middle-river/color_epd_photo3/README.txt

http://middleriver.chagasi.com/electronics/color_epd_photo3/
