middle-river/color_epd_photo3/docs/README.md

<!DOCTYPE html>
<html>
<body style="background-color: #ccccff;">
<!-- var -->
<p>[English] <a href="#lang_ja">[日本語]</a></p>
<h1 align="center">Large Photo Frame with 13.3 inch 6 Color E-Paper</h1>
<h2>Introduction</h2>
<p>After making a <a href="https&#58;//github.com/middle-river/color_epd_photo2">photo frame using a 7.3 inch 7 color e-paper display</a>, I newly got a new 13.3 inch 6 color e-paper, so I compared the image quality with the previous e-paper and created another photo frame.</p>
<h2>Comparison of Color E-Papers (ACeP vs. Spectra 6)</h2>
<p>This new e-paper uses a new technology called Spectra 6 (E6). Compared to the previous ACeP technology, Spectra 6 has only six colors compared with seven colors of ACeP, but is said to be able to display more saturated colors. I couldn't find much evaluation results about the image quality of this e-paper, therefore compared the image quality with that of the previous color e-paper.</p>
<h3>Measuring Colors Precisely</h3>
<p>Pictures taken with digital cameras are affected by various factors like lighting and and image processing in the cameras. Therefore, I will apply color correction using a color chart (color checker). There are commercial software programs for color correction but I used here the ColorCorrectionModel library in OpenCV. Color correction is performed by affine transforming the RGB color channels. It can also automatically detect a color chart in an image. This OpenCV library is highly customizable, so any color chart can be used as long as the exact colors are known (in the Lab color space). Here, I used a 24-color chart from Charttu. There seem to be several other color charts, in addition to major color checkers from X-Rite and Datacolor, such as the Pantone Color Matching Card and DGK Color Calibration Chart.</p>
<p>For color correction, it is best to use images obtained from image sensors of digital cameras directly. Color correction may not be accurate for images which undergone nonlinear processing such as white balance adjustment and noise reduction. In this evaluation, I used RAW images taken with a mirrorless camera, and converted them as Linear 16 bit images using the dcraw program. The code used for color correction can be found <a href="https&#58;//github.com/middle-river/color_epd_photo3/tree/main/color_correction">here</a>. All of the photos on this page that show a color chart were taken under natural light and color-corrected.</p>
<h3>Comparison with Color Patterns</h3>
<p>First, I created simple color pattern images with 7 or 6 colors for comparison. Below are the color patterns and the commands I used to generate the images.</p>
<div align="center">
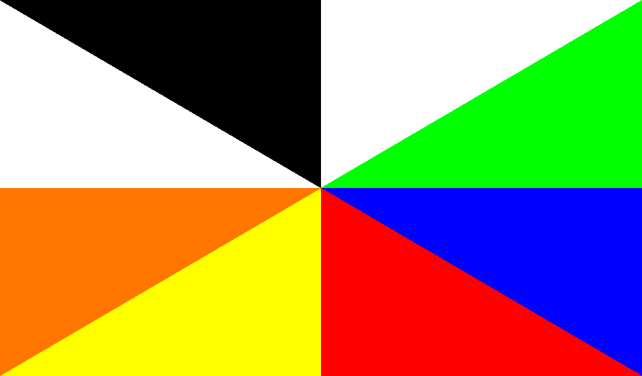
[picture p1: docs/pattern_lcd_1024x600.png]
<figure style="display: inline-table;"><a href="pattern_lcd_1024x600.png"><figcaption>Color pattern for 7&quot; tablet</figcaption></a></figure>
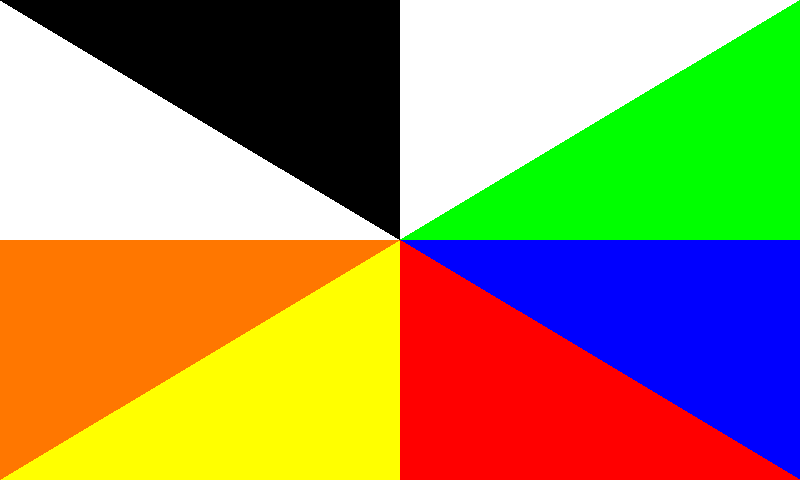
[picture p2: docs/pattern_acep_800x480.png]
<figure style="display: inline-table;"><a href="pattern_acep_800x480.png"><figcaption>Color pattern for 7.3&quot; ACeP</figcaption></a></figure>
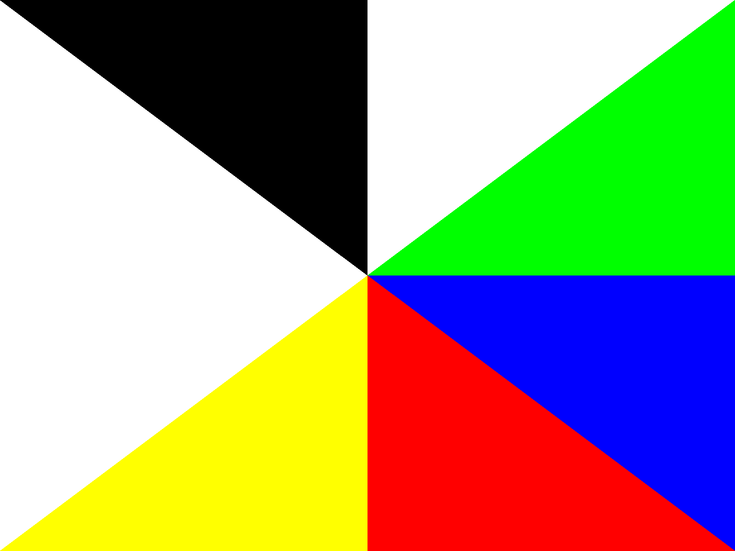
[picture p3: docs/pattern_spectra6_1600x1200.png]
<figure style="display: inline-table;"><a href="pattern_spectra6_1600x1200.png"><figcaption>Color pattern for 13.3&quot; Spectra 6</figcaption></a></figure>
</div>

<pre style="background-color: #ccffcc">
convert -size 1024x600 "xc:white" +antialias \
  -draw "fill #000000 polygon 0,0, 511.5,299.5 511.5,0" \
  -draw "fill #ffffff polygon 511.5,0, 511.5,299.5 1023,0" \
  -draw "fill #00ff00 polygon 1023,0, 511.5,299.5 1023,299.5" \
  -draw "fill #0000ff polygon 1023,299.5, 511.5,299.5 1023,599" \
  -draw "fill #ff0000 polygon 1023,599, 511.5,299.5 511.5,599" \
  -draw "fill #ffff00 polygon 511.5,599, 511.5,299.5 0,599" \
  -draw "fill #ff7700 polygon 0,599, 511.5,299.5 0,299.5" \
  pattern_lcd_1024x600.png

convert -size 800x480 "xc:white" +antialias \
  -draw "fill #000000 polygon 0,0, 399.5,239.5 399.5,0" \
  -draw "fill #ffffff polygon 399.5,0, 399.5,239.5 799,0" \
  -draw "fill #00ff00 polygon 799,0, 399.5,239.5 799,239.5" \
  -draw "fill #0000ff polygon 799,239.5, 399.5,239.5 799,479" \
  -draw "fill #ff0000 polygon 799,479, 399.5,239.5 399.5,479" \
  -draw "fill #ffff00 polygon 399.5,479, 399.5,239.5 0,479" \
  -draw "fill #ff7700 polygon 0,479, 399.5,239.5 0,239.5" \
  pattern_acep_800x480.png

convert -size 1600x1200 "xc:white" +antialias \
  -draw "fill #000000 polygon 0,0, 799.5,599.5 799.5,0" \
  -draw "fill #ffffff polygon 799.5,0, 799.5,599.5 1599,0" \
  -draw "fill #00ff00 polygon 1599,0, 799.5,599.5 1599,599.5" \
  -draw "fill #0000ff polygon 1599,599.5, 799.5,599.5 1599,1199" \
  -draw "fill #ff0000 polygon 1599,1199, 799.5,599.5 799.5,1199" \
  -draw "fill #ffff00 polygon 799.5,1199, 799.5,599.5 0,1199" \
  pattern_spectra6_1600x1200.png
</pre>
<p>The photo below compares these color patterns that are actually displayed.</p>
<div align="center">
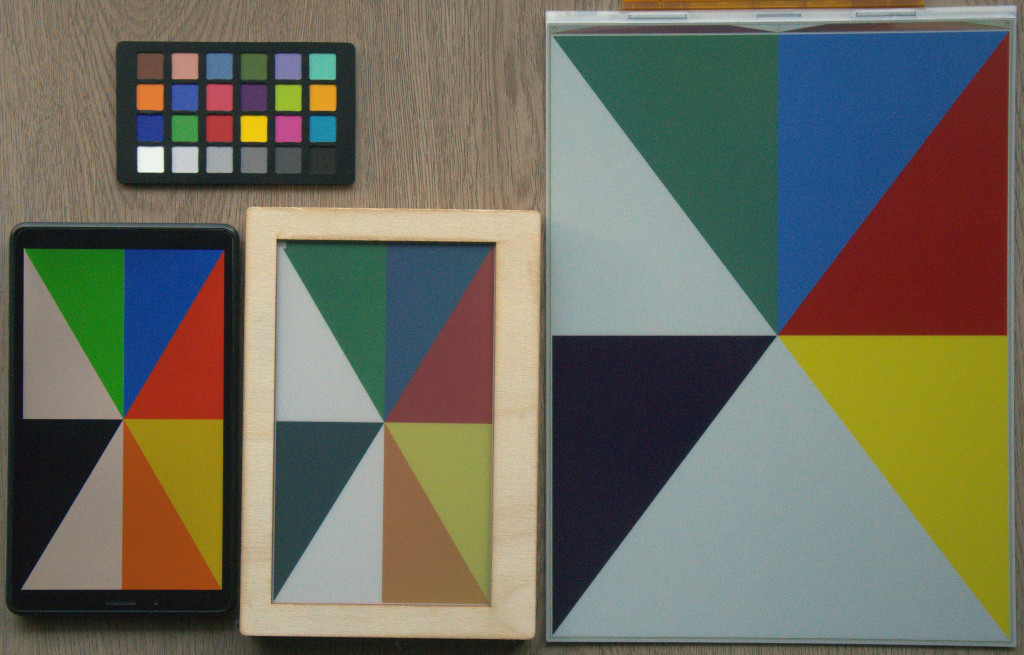
[picture p4: docs/pattern_comparison.jpg]
<figure style="display: inline-table;"><a href="pattern_comparison.jpg"><figcaption>Comparison of color patterns (from left&#58; tablet, ACeP, Spectra 6)</figcaption></a></figure>
</div>
<p>From the left, there are an LCD display (7&quot; tablet Lenovo Tab M7 3rd Gen, screen brightness of 50%), a 7.3&quot; ACeP color e-paper, and a 13.3&quot; Spectra 6 color e-paper. Naturally, the e-papers have inferior color saturation compared to the LCD.</p>
<p>The RGB and HSV values for each color on the e-papers were as follows&#58;</p>
<table align="center" border="1">
<tr>
<td align="center"><strong>Color</strong></td>
<td align="center"><strong>Pure Color (RGB)</strong></td>
<td align="center"><strong>ACeP (RGB)</strong></td>
<td align="center"><strong>Spectra 6 (RGB)</strong></td>
<td align="center"><strong>Pure Color (HSV)</strong></td>
<td align="center"><strong>ACeP (HSV)</strong></td>
<td align="center"><strong>Spectra 6 (HSV)</strong></td>
</tr>
<tr>
<td align="center">Black</td>
<td align="center">(  0,   0,   0)</td>
<td align="center">( 46,  67,  71)</td>
<td align="center">( 30,  27,  43) </td>
<td align="center">(0  ,   0,   0)</td>
<td align="center">(189,  35,  27)</td>
<td align="center">(251,  37,  16)</td>
</tr>
<tr>
<td align="center">White</td>
<td align="center">(255, 255, 255)</td>
<td align="center">(176, 182, 178)</td>
<td align="center">(156, 171, 169) </td>
<td align="center">(0  ,   0, 100)</td>
<td align="center">(140,   3,  71)</td>
<td align="center">(172,   8,  67)</td>
</tr>
<tr>
<td align="center">Green</td>
<td align="center">(  0, 255,   0)</td>
<td align="center">( 49,  99,  75)</td>
<td align="center">( 49,  92,  77) </td>
<td align="center">(120, 100, 100)</td>
<td align="center">(151,  50,  38)</td>
<td align="center">(159,  46,  36)</td>
</tr>
<tr>
<td align="center">Blue</td>
<td align="center">(  0,   0, 255)</td>
<td align="center">( 54,  82, 105)</td>
<td align="center">( 35,  81, 136) </td>
<td align="center">(240, 100, 100)</td>
<td align="center">(207,  48,  41)</td>
<td align="center">(212,  74,  53)</td>
</tr>
<tr>
<td align="center">Red</td>
<td align="center">(255,   0,   0)</td>
<td align="center">(121,  64,  65)</td>
<td align="center">(109,  26,  23) </td>
<td align="center">(  0, 100, 100)</td>
<td align="center">(358,  47,  47)</td>
<td align="center">(  2,  78,  42)</td>
</tr>
<tr>
<td align="center">Yellow</td>
<td align="center">(255, 255,   0)</td>
<td align="center">(151, 154,  77)</td>
<td align="center">(153, 149,  23) </td>
<td align="center">( 60, 100, 100)</td>
<td align="center">( 62,  50,  60)</td>
<td align="center">( 58,  84,  60)</td>
</tr>
<tr>
<td align="center">Orange</td>
<td align="center">(255, 127,   0)</td>
<td align="center">(138, 102,  68)</td>
<td align="center">N/A             </td>
<td align="center">( 29, 100, 100)</td>
<td align="center">( 29,  50,  54)</td>
<td align="center">N/A</td>
</tr>
</table>
<p>Comparing saturation in the photo and RGB values, Spectra 6 is better than ACeP in blue, red, and yellow, but green is slightly worse.</p>
<h3>Comparison with Test Images</h3>
<p>The e-papers were compared using test images. Since color e-papers can display only 7 or 6 colors, we need to reduce the number of colors in images using color palettes and dithering. Here, the following four color palettes were used.</p>
<dl>
<dt><strong>Palette A</strong></dt>
<dd>Pure color palette (&quot;Pure Colors (RGB)&quot; in the table above)</dd>
<dt><strong>Palette B</strong></dt>
<dd>Actual display color palette (&quot;Spectra 6 (RGB)&quot; in the table above)</dd>
<dt><strong>Palette C</strong></dt>
<dd>Color palette derived from a sample image of ACeP e-paper (See &quot;sample image palette&quot; in the <a href="https&#58;//github.com/middle-river/color_epd_photo2">previous project</a>)</dd>
<dt><strong>Palette D</strong></dt>
<dd>Color palette adaptively determined for images (See &quot;Experiment of Optimizing Palettes&quot; in the <a href="https&#58;//github.com/middle-river/color_epd_photo2">previous project</a>)</dd>
</dl>
<p><a href="https&#58;//github.com/middle-river/color_epd_photo3/tree/main/tool/reduce_colors.py">This</a> (Palette A-C) and <a href="https&#58;//github.com/middle-river/color_epd_photo2/tree/main/palette_optimizer/convert_colors.py">this</a> (Palette D) scripts were used for color reduction. The images used for the test were available in <a href="https&#58;//www.northlight-images.co.uk/printer-test-images/">this page</a>.</p>
<div align="center">
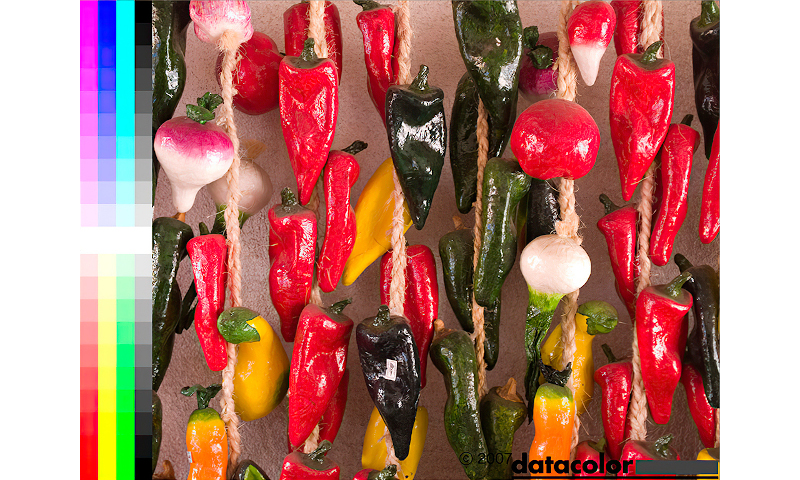
[picture p5: docs/datacolor0.jpg]
<figure style="display: inline-table;"><a href="datacolor0.jpg"><figcaption>Image A</figcaption></a></figure>
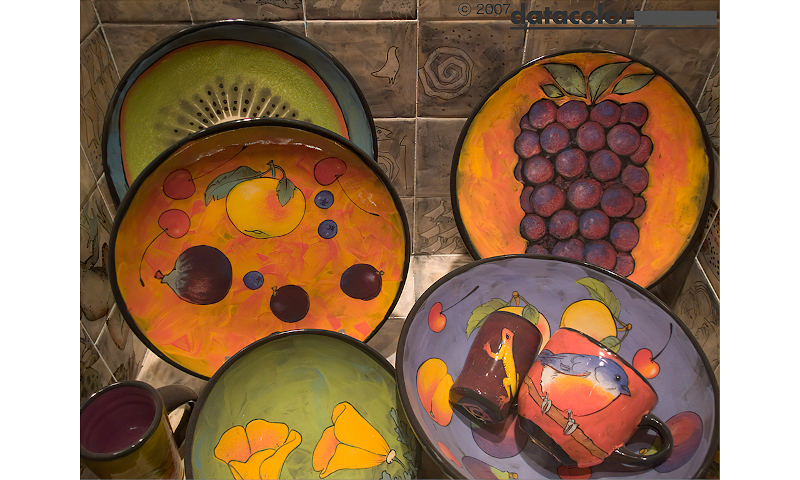
[picture p6: docs/datacolor1.jpg]
<figure style="display: inline-table;"><a href="datacolor1.jpg"><figcaption>Image B</figcaption></a></figure>
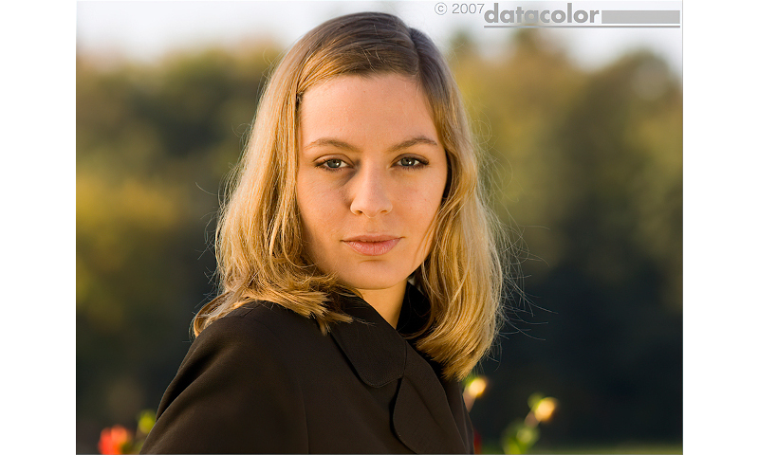
[picture p7: docs/datacolor2.jpg]
<figure style="display: inline-table;"><a href="datacolor2.jpg"><figcaption>Image C</figcaption></a></figure>
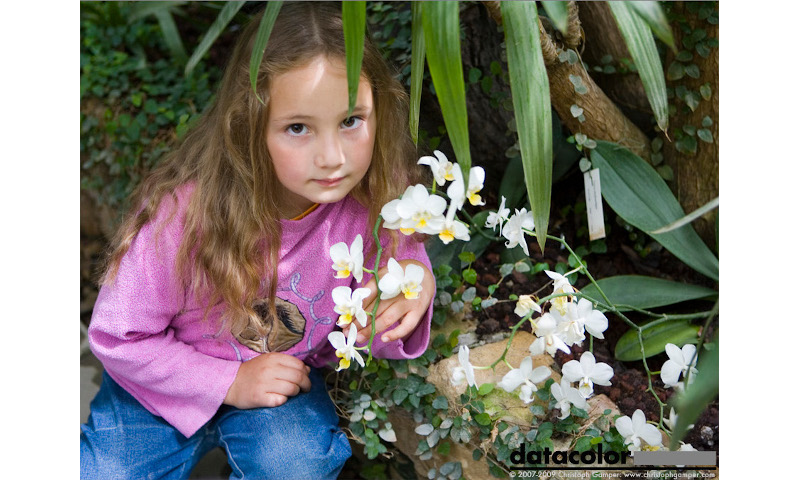
[picture p8: docs/datacolor3.jpg]
<figure style="display: inline-table;"><a href="datacolor3.jpg"><figcaption>Image D</figcaption></a></figure>
</div>
<p>The results are shown below.</p>
<div align="center">
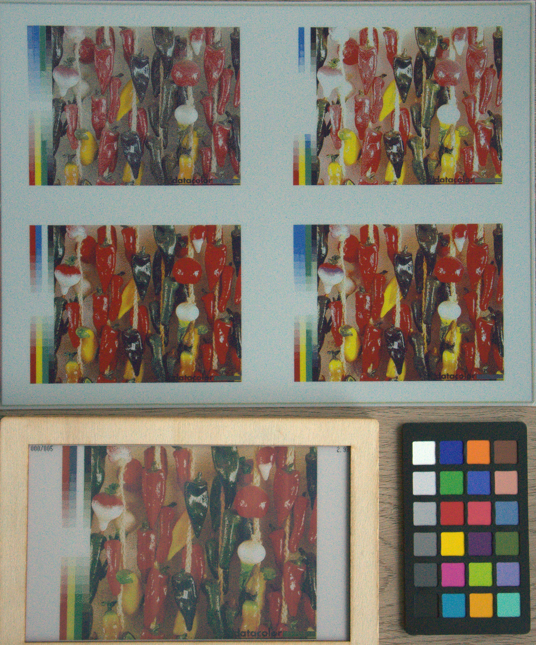
[picture p9: docs/result0.jpg]
<figure style="display: inline-table;"><a href="result0.jpg"><figcaption>Result of Image A</figcaption></a></figure>
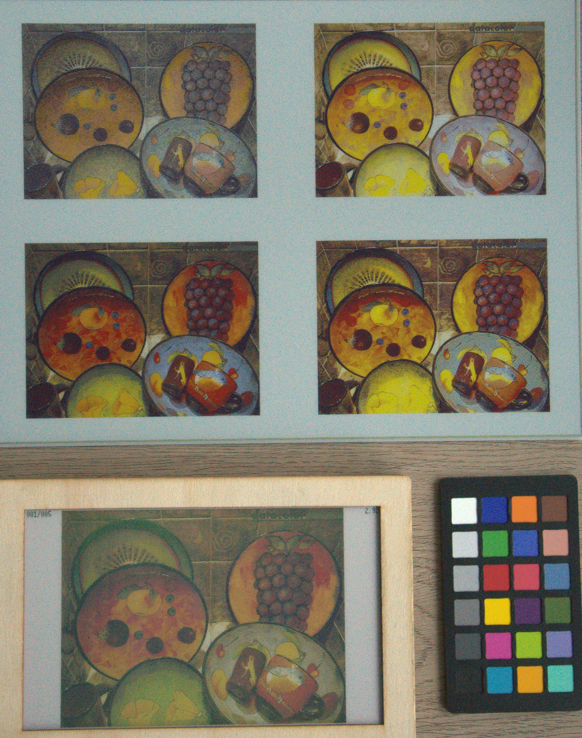
[picture p10: docs/result1.jpg]
<figure style="display: inline-table;"><a href="result1.jpg"><figcaption>Result of Image B</figcaption></a></figure>
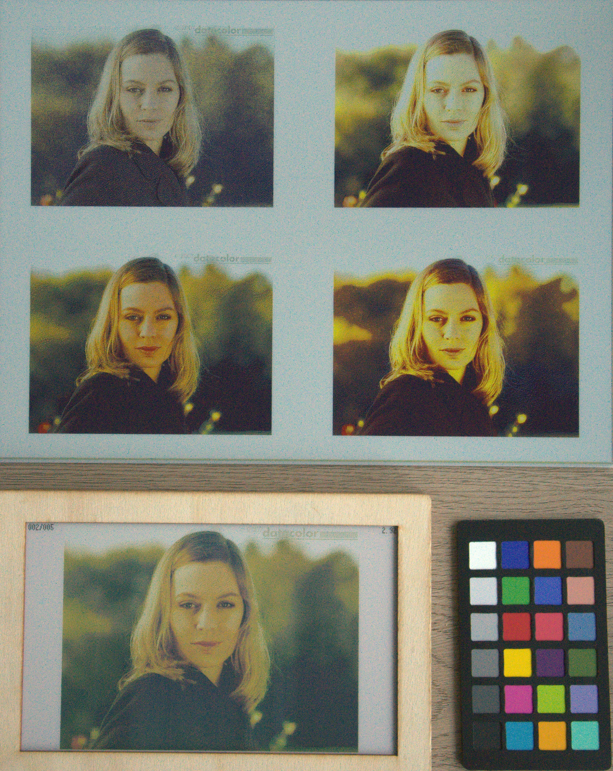
[picture p11: docs/result2.jpg]
<figure style="display: inline-table;"><a href="result2.jpg"><figcaption>Result of Image C</figcaption></a></figure>
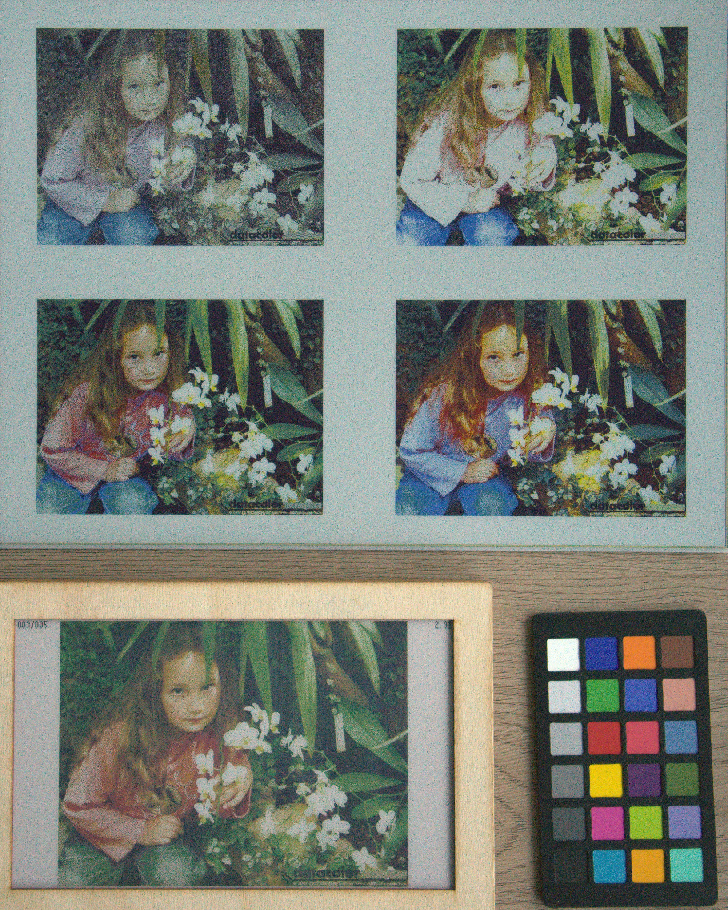
[picture p12: docs/result3.jpg]
<figure style="display: inline-table;"><a href="result3.jpg"><figcaption>Result of Image D</figcaption></a></figure>
</div>
<p>In these pictures, the top is the 13.3&quot; Spectra 6, and the bottom left is the 7.3&quot; ACeP. There are four images in the 13.3&quot; model&#58; the top left uses Palette A, the top right uses Palette B, the bottom left uses Palette C, and the bottom right uses Palette D. The 7.3&quot; model always uses Palette C. All images are the same size, 800x480.</p>
<p>The differences between the palettes can be seen with the 13.3&quot; display. Palette A (pure color palette) is always low in saturation and noisy. Palette B (actual palette) has blown out highlights. Palette C (palette from a sample image) has relatively stable image quality for all images. Palette D (adaptive palette) has slightly higher contrast than Palette C but colors may shift. When comparing the 13.3&quot; Spectra 6 (Palette C) to the 7.3&quot; ACeP (Palette C), the Spectra 6 often produces slightly more vibrant results. As described in the <a href="https&#58;//github.com/middle-river/color_epd_photo2">previous page</a> , color palettes used for color reduction largely impact on image quality. Palette C was originally obtained from a sample image of ACeP e-paper, but it also gave good results on Spectra 6.</p>
<p>7.3 inch ACeP took 32 seconds and 13.3 inch Spectra 6 took 22 seconds for refreshing the screen.</p>
<h2>Hardware</h2>
<p>The 6 color e-paper used here is <a href="https&#58;//www.waveshare.com/13.3inch-e-paper-hat-plus-e.htm?sku=29355">Waveshare 13.3inch e-Paper HAT+ (E)</a>, with the resolution of 1200x1600. The control of this e-paper is a bit tricky compared to previous ones. It has two controllers, and there are two chip select (CS) signals. The PWR signal was added to completely cut off the power supply with MOS-FET, so power consumption can be reduced to zero when not in use (not applicable to Raspberry Pi GPIO pins). There is a D/C signal to distinguish between commands and data, but it is not actually used. Data are sent immediately after each command, and CS must be kept low during the whole cycle. This is a large e-paper, and the current consumption is large (1.4 A at maximum according to the specification). It did not work with two AA batteries due to voltage drop.</p>
<p>ESP32 with 16 MB flash memory was used for controlling the e-paper. 1,280 KB was assigned to the program area, and the rest to LittleFS storage area.</p>
<p>The circuit is similar to the previous one, and the wiring is as follows.</p>
<table align="center" border="1">
<tr>
<td align="left">BAT&#58;4.5V</td>
<td align="left">EPD&#58;VCC</td>
</tr>
<tr>
<td align="left">BAT&#58;GND</td>
<td align="left">EPD&#58;GND</td>
</tr>
<tr>
<td align="left">ESP&#58;3V3</td>
<td align="left">BAT&#58;3.3V</td>
</tr>
<tr>
<td align="left">ESP&#58;GND</td>
<td align="left">BAT&#58;GND</td>
</tr>
<tr>
<td align="left">ESP&#58;IO23(MOSI)</td>
<td align="left">EPD&#58;DIN</td>
</tr>
<tr>
<td align="left">ESP&#58;IO18(CLK)</td>
<td align="left">EPD&#58;SCK</td>
</tr>
<tr>
<td align="left">ESP&#58;IO19</td>
<td align="left">EPD&#58;CS_M</td>
</tr>
<tr>
<td align="left">ESP&#58;IO22</td>
<td align="left">EPD&#58;CS_S</td>
</tr>
<tr>
<td align="left">ESP&#58;IO21</td>
<td align="left">EPD&#58;DC</td>
</tr>
<tr>
<td align="left">ESP&#58;IO17</td>
<td align="left">EPD&#58;RST</td>
</tr>
<tr>
<td align="left">ESP&#58;IO16</td>
<td align="left">EPD&#58;BUSY</td>
</tr>
<tr>
<td align="left">ESP&#58;IO4</td>
<td align="left">EPD&#58;PWR</td>
</tr>
<tr>
<td align="left">ESP&#58;IO3(RXD)</td>
<td align="left">CON&#58;RXD</td>
</tr>
<tr>
<td align="left">ESP&#58;IO1(TXD)</td>
<td align="left">CON&#58;TXD</td>
</tr>
</table>
<p>ESP, EPD, BAT, and CON respectively represent ESP32, e-paper, battery, and the connector for programming the flash. Three AA batteries are used for power suply&#58; 4.5 V is input to the e-paper, and 3.3 V is input to ESP32 which is obtained with MCP1700T-3302E. A battery holder with a small contact resistance is used since a large current is drained. A 11x14 inch photo frame is used for enclosing the e-paper.</p>
<div align="center">
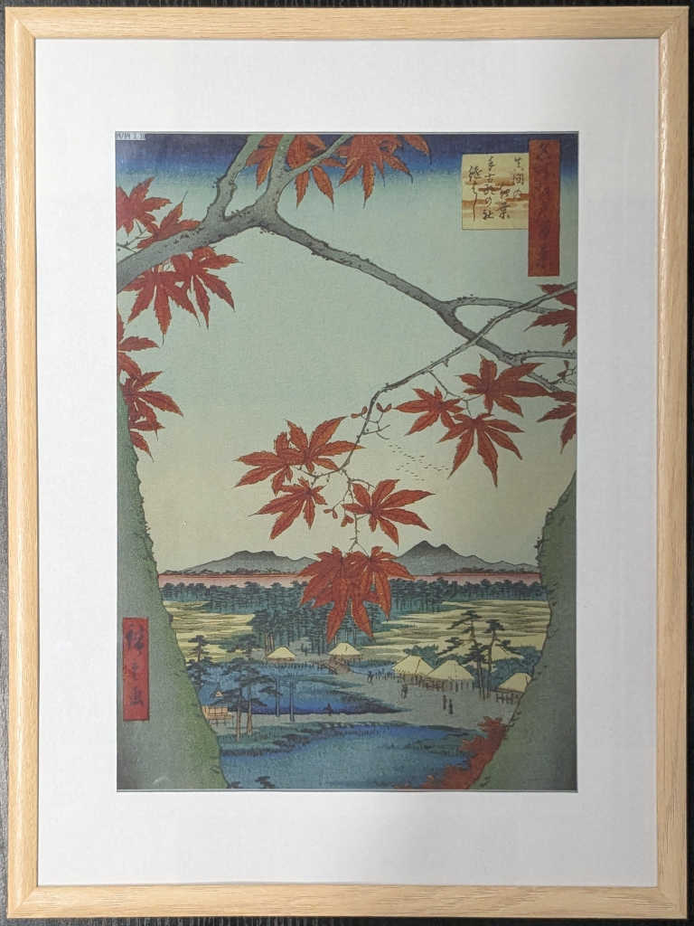
[picture p13: docs/front.jpg]
<figure style="display: inline-table;"><a href="front.jpg"><figcaption>Cased device (front)</figcaption></a></figure>
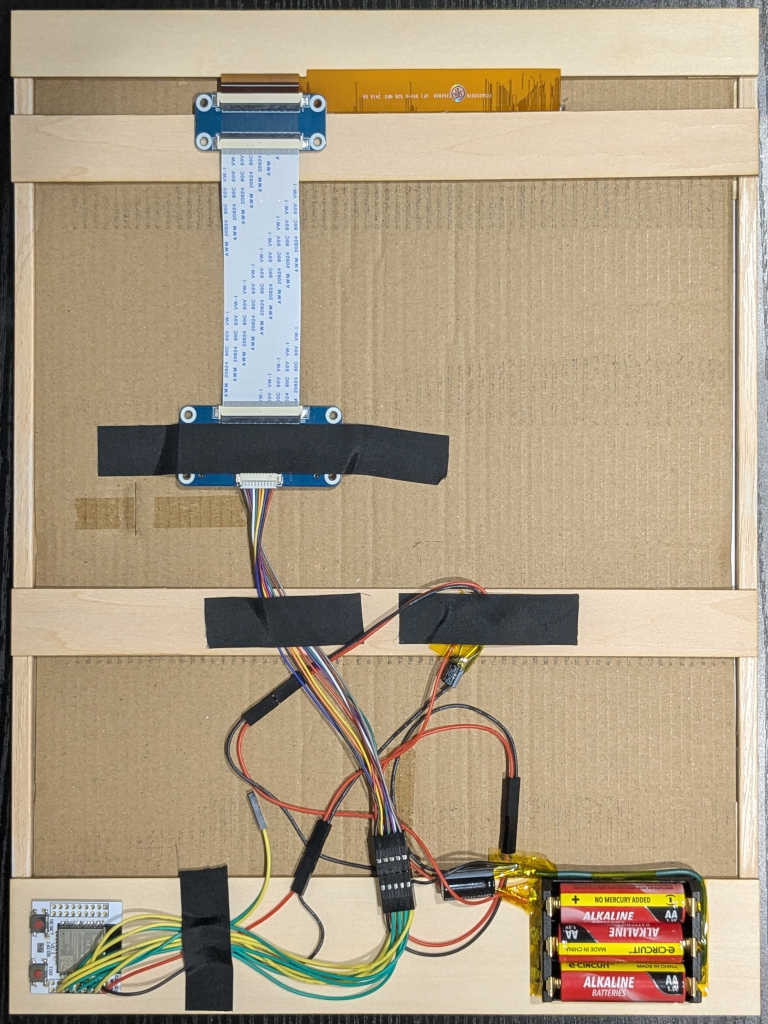
[picture p14: docs/back.jpg]
<figure style="display: inline-table;"><a href="back.jpg"><figcaption>Cased device (back)</figcaption></a></figure>
</div>
<h2>Software</h2>
<p>A <a href="https&#58;//github.com/middle-river/color_epd_photo3/tree/main/firmware">firmware</a> for the Arduino ESP32 was written in order to use this 13.3&quot; e-paper as a photo frame.</p>
<h3>Usage</h3>
<p>This photo frame is normally in the deep sleep state, but it wakes up and rewrite images when the specified sleep time has elapsed or the tactile switch (connected to GPIO0) is pressed. This photo frame is controlled using only the single switch. By pressing the switch when powering on or resetting, several settings can be configured and image data can be transferred. There exist the following operating modes.</p>
<ul>
<li><strong>Configuration mode</strong><br>This mode is activated when the switch is pressed for 2 seconds or more within 3 seconds after power-on. The device will sleep by sending an empty string as the key.</li>
<li><strong>Sync mode</strong><br>This mode is activated when the switch is pressed less than 2 seconds within 3 seconds after power-on. The device will sleep after syncing the data.</li>
<li><strong>Transfer mode</strong><br>This mode is activated when the switch is pressed two times within 3 seconds after power-on. The device will sleep when the switch is pressed once again.</li>
<li><strong>Displaying the next image</strong><br>This mode is activated when the switch is pressed less than 2 seconds in the sleep state, or the sleep time elapsed. The device will sleep after displaying the next image.</li>
<li><strong>Displaying the previous image</strong><br>This mode is activated when the switch is pressed 2 seconds or more in the sleep state. The device will sleep after displaying the previous image.</li>
<li><strong>Displaying the 5th next image</strong><br>This mode is activated when the switch is pressed two times in the sleep state. The device will sleep after displaying the 5th next image.</li>
<li><strong>Displaying the 5th previous image</strong><br>This mode is activated when the switch is pressed three times in the sleep state. The device will sleep after displaying the 5th previous image.</li>
</ul>
<p>In the configuration mode, an HTTP server runs in the Access Point mode. The device can be configured by connecting to the server (SSID is &quot;ESP32&quot;, password is &quot;12345678&quot;, and URL is &quot;http&#58;//192.168.0.1/&quot;) with a smartphone or tablet. Any key-value pair can be registered in this mode. The SSID/password for the transfer/sync mode, the URL for the sync mode, and the sleep time (in seconds) are set using the keys &quot;SSID&quot;, &quot;PASS&quot;, &quot;URL&quot;, and &quot;SLEEP&quot; respectively. These values are saved on the flash memory.</p>
<p>In the sync mode, image files in a specified web server directory are automatically transferred to the ESP32. The server directory needs to be set for the key &quot;URL&quot; in the configuration mode. The URL needs to end with a slash. HTTP Basic Authentication can be used with a URL like &quot;http&#58;//user&#58;password@example.com/dir/subdir/&quot;. Note that file sizes are used for checking file identity, so files will not be updated when the files in the server are replaced with new files with the same sizes. It is also possible to update key-value configurations by putting a file named config.txt in the directory, which has a tab-separated key-value pair in each line. In the web server directory for storing images, the following files .htaccess and index.cgi also need to be placed in order to obtain the list of files.</p>

<pre style="background-color: #ccffcc">
[.htaccess]
Options +ExecCGI
AddHandler cgi-script .cgi

[index.cgi]
#!/bin/sh
echo "Content-Type: text/plain"
echo ""
find . -maxdepth 1 -name "*.gif" -printf '%s %f\n'
</pre>
<p>In the transfer mode, the device connects to an access point in the Station mode and runs an FTP server. We can connect with FTP client software and upload or delete image files. In Windows, File Explorer can be used as an FTP client. All image files need to be placed in the root directory of ESP32. I used the Arduino library SimpleFTPServer (in order to use LittleFS instead of SPIFFS, DEFAULT_STORAGE_TYPE_ESP32 in FtpServerKey.h needs to be changed from STORAGE_SPIFFS to STORAGE_LITTLEFS).</p>
<h3>Image Data</h3>
<p>Image data are stored in the GIF format as in the previous photo frame. Since this e-paper has two controllers assigned to the left and right sides of the display area and needs to transfer data separately, 1200x1600 images are divided into left and right halves and converted into 600x3200 images by vertically merging in advance. File sizes depend on the images, but they were usually around 250 to 450KB. About 60 images can be stored when 15 MB is assigned to LittleFS and the size of each image is 250 KB.</p>
<p>The power voltage of ESP32 and the index number of the currently displaying image are shown  in the upper left corner of the screen.</p>
<h2>Final Thoughts</h2>
<p>Compared to the ACeP e-paper, the image quality of the Spectra 6 e-paper was not different as I expected. The difference is recognizable when compared side by side, but the image resolution is similary limited due to dithering since each pixel can only display six colors. The faster refresh time is one advantage of the new e-paper.</p>
<hr>
<!-- var -->
<p><a href="#lang_en">[English]</a> [日本語]</p>
<h1 align="center">13.3インチ6色カラー電子ペーパーを使った大型フォトフレーム</h1>
<h2>はじめに</h2>
<p>最近<a href="https&#58;//github.com/middle-river/color_epd_photo2">7.3インチの7色カラー電子ペーパーを使用してフォトフレームを作成</a>しましたが、新型の13.3インチ6色カラー電子ペーパーを新たに入手したので、以前の電子ペーパーと画質を比較して、フォトフレームを作りました。</p>
<h2>カラー電子ペーパーの比較(ACePとSpectra 6)</h2>
<p>今回使用した電子ペーパーは13.3インチと大型であることの他に、Spectra 6 (E6)という新しい技術が使われているという特徴があります。Spectra 6は以前のカラー電子ペーパーで使われていたACePという技術と比較して、表示可能な色数は7色から6色に減りますがより高彩度の表示ができると言われています。しかしながらWeb上ではこの電子ペーパーの画質に関する客観的な情報があまり見つからなかったので、以前のカラー電子ペーパーと画質を比べてみました。</p>
<h3>正確な色の測定</h3>
<p>デジカメで電子ペーパーの表示結果を撮影した場合、その画像は照明やカメラの画像処理エンジンなど様々な要素の影響を受けます。そこで今回はカラーチャート(カラーチェッカー)を使って撮影した写真の色を補正することにしました。色補正をするソフトは市販のものもありますが、OpenCVにColorCorrectionModelというライブラリがあるのでそれを使いました。基本的にRGBのカラーチャンネルをアフィン変換することで色補正を行います。また画像の中からカラーチャートを自動検出することもできます。このOpenCVのライブラリはカスタマイズ性が高いので、正確な色(Lab色空間での値)が分かっていればどのようなカラーチャートでも利用できます。今回は、Charttu社の24色のカラーチャートを使用しました。X-Rite社やDatacolor社のメジャーなカラーチェッカーの他に、Pantone Color Matching CardやDGK Color Calibration Chartなどいくつかの色補正用カラーチャートが存在するようです。</p>
<p>色補正の対象となる画像はイメージセンサーから出力された値を直接使うのが望ましく、ホワイトバランス調整やノイズ除去などの非線形な処理を行った画像に対しては色補正の精度が悪くなります。そこで今回は、デジタル一眼カメラで撮影したRAWデータをdcrawというソフトでLinear 16 bitで現像した画像を使いました。色補正に使用したコードは<a href="https&#58;//github.com/middle-river/color_epd_photo3/tree/main/color_correction">ここ</a>にあります。このページに載せた写真でカラーチャートが写っているものは、全て自然光の下で撮影して色補正を行った後の写真です(ただし縮小してJPEG圧縮してあります)。</p>
<h3>カラーパターンの比較</h3>
<p>まず最初に、7色または6色からなる単純なカラーパターンを作成して比較しました。以下にそのカラーパターンと、画像生成に使用したコマンドを示します。</p>
<div align="center">
<figure style="display: inline-table;"><a href="pattern_lcd_1024x600.png"><figcaption>7インチタブレット用パターン</figcaption></a></figure>
<figure style="display: inline-table;"><a href="pattern_acep_800x480.png"><figcaption>7.3インチACeP用パターン</figcaption></a></figure>
<figure style="display: inline-table;"><a href="pattern_spectra6_1600x1200.png"><figcaption>13.3インチSpectra 6用パターン</figcaption></a></figure>
</div>

<pre style="background-color: #ccffcc">
convert -size 1024x600 "xc:white" +antialias \
  -draw "fill #000000 polygon 0,0, 511.5,299.5 511.5,0" \
  -draw "fill #ffffff polygon 511.5,0, 511.5,299.5 1023,0" \
  -draw "fill #00ff00 polygon 1023,0, 511.5,299.5 1023,299.5" \
  -draw "fill #0000ff polygon 1023,299.5, 511.5,299.5 1023,599" \
  -draw "fill #ff0000 polygon 1023,599, 511.5,299.5 511.5,599" \
  -draw "fill #ffff00 polygon 511.5,599, 511.5,299.5 0,599" \
  -draw "fill #ff7700 polygon 0,599, 511.5,299.5 0,299.5" \
  pattern_lcd_1024x600.png

convert -size 800x480 "xc:white" +antialias \
  -draw "fill #000000 polygon 0,0, 399.5,239.5 399.5,0" \
  -draw "fill #ffffff polygon 399.5,0, 399.5,239.5 799,0" \
  -draw "fill #00ff00 polygon 799,0, 399.5,239.5 799,239.5" \
  -draw "fill #0000ff polygon 799,239.5, 399.5,239.5 799,479" \
  -draw "fill #ff0000 polygon 799,479, 399.5,239.5 399.5,479" \
  -draw "fill #ffff00 polygon 399.5,479, 399.5,239.5 0,479" \
  -draw "fill #ff7700 polygon 0,479, 399.5,239.5 0,239.5" \
  pattern_acep_800x480.png

convert -size 1600x1200 "xc:white" +antialias \
  -draw "fill #000000 polygon 0,0, 799.5,599.5 799.5,0" \
  -draw "fill #ffffff polygon 799.5,0, 799.5,599.5 1599,0" \
  -draw "fill #00ff00 polygon 1599,0, 799.5,599.5 1599,599.5" \
  -draw "fill #0000ff polygon 1599,599.5, 799.5,599.5 1599,1199" \
  -draw "fill #ff0000 polygon 1599,1199, 799.5,599.5 799.5,1199" \
  -draw "fill #ffff00 polygon 799.5,1199, 799.5,599.5 0,1199" \
  pattern_spectra6_1600x1200.png
</pre>
<p>これらのカラーパターンを実際に表示したものを比較したのが下の写真です。</p>
<div align="center">
<figure style="display: inline-table;"><a href="pattern_comparison.jpg"><figcaption>カラーパターンの比較(左からタブレット、ACeP、Spectra 6)</figcaption></a></figure>
</div>
<p>左から順に液晶ディスプレイ(7インチタブレットLenovo Tab M7 3rd Gen、画面輝度は50%)、7.3インチACePカラー電子ペーパー、13.3インチSpectra 6カラー電子ペーパーです。さすがに液晶に比べると電子ペーパーは彩度が劣ります。</p>
<p>電子ペーパーの各色のRGB値とHSV値は下記の通りになりました。</p>
<table align="center" border="1">
<tr>
<td align="center"><strong>色</strong></td>
<td align="center"><strong>純色 (RGB)</strong></td>
<td align="center"><strong>ACeP (RGB)</strong></td>
<td align="center"><strong>Spectra 6 (RGB)</strong></td>
<td align="center"><strong>純色 (HSV)</strong></td>
<td align="center"><strong>ACeP (HSV)</strong></td>
<td align="center"><strong>Spectra 6 (HSV)</strong></td>
</tr>
<tr>
<td align="center">黒</td>
<td align="center">(  0,   0,   0)</td>
<td align="center">( 46,  67,  71)</td>
<td align="center">( 30,  27,  43) </td>
<td align="center">(0  ,   0,   0)</td>
<td align="center">(189,  35,  27)</td>
<td align="center">(251,  37,  16)</td>
</tr>
<tr>
<td align="center">白</td>
<td align="center">(255, 255, 255)</td>
<td align="center">(176, 182, 178)</td>
<td align="center">(156, 171, 169) </td>
<td align="center">(0  ,   0, 100)</td>
<td align="center">(140,   3,  71)</td>
<td align="center">(172,   8,  67)</td>
</tr>
<tr>
<td align="center">緑</td>
<td align="center">(  0, 255,   0)</td>
<td align="center">( 49,  99,  75)</td>
<td align="center">( 49,  92,  77) </td>
<td align="center">(120, 100, 100)</td>
<td align="center">(151,  50,  38)</td>
<td align="center">(159,  46,  36)</td>
</tr>
<tr>
<td align="center">青</td>
<td align="center">(  0,   0, 255)</td>
<td align="center">( 54,  82, 105)</td>
<td align="center">( 35,  81, 136) </td>
<td align="center">(240, 100, 100)</td>
<td align="center">(207,  48,  41)</td>
<td align="center">(212,  74,  53)</td>
</tr>
<tr>
<td align="center">赤</td>
<td align="center">(255,   0,   0)</td>
<td align="center">(121,  64,  65)</td>
<td align="center">(109,  26,  23) </td>
<td align="center">(  0, 100, 100)</td>
<td align="center">(358,  47,  47)</td>
<td align="center">(  2,  78,  42)</td>
</tr>
<tr>
<td align="center">黄</td>
<td align="center">(255, 255,   0)</td>
<td align="center">(151, 154,  77)</td>
<td align="center">(153, 149,  23) </td>
<td align="center">( 60, 100, 100)</td>
<td align="center">( 62,  50,  60)</td>
<td align="center">( 58,  84,  60)</td>
</tr>
<tr>
<td align="center">橙</td>
<td align="center">(255, 127,   0)</td>
<td align="center">(138, 102,  68)</td>
<td align="center">N/A             </td>
<td align="center">( 29, 100, 100)</td>
<td align="center">( 29,  50,  54)</td>
<td align="center">N/A</td>
</tr>
</table>
<p>写真やRGB値で彩度を比較すると、ACePに対してSpectra 6は青と赤と黄で良くなっていますが、緑はやや悪化しています。</p>
<h3>テスト画像の比較</h3>
<p>実際にテスト用画像を表示して比較しました。カラー電子ペーパーでは7色あるいは6色しか表示できないので、カラーパレットとディザリングを使って表示する画像を減色する必要がありますが、ここでは以下の4つのカラーパレットを使いました。</p>
<dl>
<dt><strong>パレットA</strong></dt>
<dd>純色のカラーパレット(上の表の&quot;純色 (RGB)&quot;)</dd>
<dt><strong>パレットB</strong></dt>
<dd>実際の表示色のカラーパレット(上の表の&quot;Spectra 6 (RGB)&quot;)</dd>
<dt><strong>パレットC</strong></dt>
<dd>ACeP電子ペーパーのサンプル画像から求めたカラーパレット(<a href="https&#58;//github.com/middle-river/color_epd_photo2">以前のページ</a>の&quot;サンプル画像のパレット&quot;を参照)</dd>
<dt><strong>パレットD</strong></dt>
<dd>画像に対して適応的に求めたカラーパレット(<a href="https&#58;//github.com/middle-river/color_epd_photo2">以前のページ</a>の&quot;パレット最適化の実験&quot;を参照)</dd>
</dl>
<p>減色に使用したスクリプトは<a href="https&#58;//github.com/middle-river/color_epd_photo3/tree/main/tool/reduce_colors.py">これ</a>(パレットA-C)と<a href="https&#58;//github.com/middle-river/color_epd_photo2/tree/main/palette_optimizer/convert_colors.py">これ</a>(パレットD)です。テストに使用した画像は<a href="https&#58;//www.northlight-images.co.uk/printer-test-images/">こちらのページ</a>の以下のものです。</p>
<div align="center">
<figure style="display: inline-table;"><a href="datacolor0.jpg"><figcaption>画像A</figcaption></a></figure>
<figure style="display: inline-table;"><a href="datacolor1.jpg"><figcaption>画像B</figcaption></a></figure>
<figure style="display: inline-table;"><a href="datacolor2.jpg"><figcaption>画像C</figcaption></a></figure>
<figure style="display: inline-table;"><a href="datacolor3.jpg"><figcaption>画像D</figcaption></a></figure>
</div>
<p>そして実際に表示した結果が下の通りです。</p>
<div align="center">
<figure style="display: inline-table;"><a href="result0.jpg"><figcaption>画像Aの表示結果</figcaption></a></figure>
<figure style="display: inline-table;"><a href="result1.jpg"><figcaption>画像Bの表示結果</figcaption></a></figure>
<figure style="display: inline-table;"><a href="result2.jpg"><figcaption>画像Cの表示結果</figcaption></a></figure>
<figure style="display: inline-table;"><a href="result3.jpg"><figcaption>画像Dの表示結果</figcaption></a></figure>
</div>
<p>この写真の中で、上が13.3インチSpectra 6で、左下が7.3インチACePです。13.3インチの方には4つの画像がありますが、左上がパレットA、右上がパレットB、左下がパレットC、右下がパレットDを使った画像です。7.3インチではパレットCを使っています。それぞれの画像は全て800x480の同じサイズです。</p>
<p>13.3インチの表示例を見るとパレット毎の違いが分かります。パレットA(純色パレット)は常に彩度が低くノイジーです。パレットB(実際のパレット)はハイライトが飛びやすいです。パレットC(サンプル画像のパレット)はどの画像でも比較的画質が安定しています。パレットD(適応的パレット)はパレットCよりもややコントラストが高くなりますが色が変わってしまうことがあります。</p>
<p>13.3インチのSpectra 6 (パレットC)と7.3インチのACePを比較すると、多くの場合Spectra 6の方がやや鮮やかな結果が得られています。</p>
<p><a href="https&#58;//github.com/middle-river/color_epd_photo2">以前のページ</a>で説明したように、減色で使用するカラーパレットにより画質が大きな影響を受けます。パレットCは、元々ACePカラー電子ペーパーのサンプル画像から得たカラーパレットですが、Spectra 6でもよい結果が得られました。</p>
<p>なお描画速度に関しては、7.3インチACePが32秒であるのに対して13.3インチSpectra 6は22秒でした。</p>
<h2>ハードウェア</h2>
<p>今回使用した6色の電子ペーパーは、Waveshare社の<a href="https&#58;//www.waveshare.com/13.3inch-e-paper-hat-plus-e.htm?sku=29355">13.3inch e-Paper HAT+ (E)</a>というもので解像度は1200x1600です。この電子ペーパーの制御は従来のものと比べてややクセがあります。まず、コントローラーが2つあるために、チップセレクト(CS)信号が2つあります。また電源をMOS-FETで完全に遮断するためのPWR信号が追加されていて、未使用時の消費電力をゼロにできます(Raspberry PiのGPIOピン使用時は無効)。コマンドとデータを区別するためにD/C信号がありますが、実際には使われておらず、コマンドの直後にデータを連続して送るようになっており、その間ずっとCSをLにしておく必要があります。また大型の電子ペーパーであるため消費電流も大きく、仕様書では最大1.4Aとなっています。そのため、単3電池2本では電圧降下のため動きませんでした。電源に十分に余裕がないと動作が不安定になりました。</p>
<p>電子ペーパーの制御には、16MBのフラッシュメモリを搭載したESP32を使いました。1,280KBをプログラム領域に割り当て、残りをLittleFSに割り当てました。</p>
<p>回路は前回と似ていて以下のとおり配線しました。</p>
<table align="center" border="1">
<tr>
<td align="left">BAT&#58;4.5V</td>
<td align="left">EPD&#58;VCC</td>
</tr>
<tr>
<td align="left">BAT&#58;GND</td>
<td align="left">EPD&#58;GND</td>
</tr>
<tr>
<td align="left">ESP&#58;3V3</td>
<td align="left">BAT&#58;3.3V</td>
</tr>
<tr>
<td align="left">ESP&#58;GND</td>
<td align="left">BAT&#58;GND</td>
</tr>
<tr>
<td align="left">ESP&#58;IO23(MOSI)</td>
<td align="left">EPD&#58;DIN</td>
</tr>
<tr>
<td align="left">ESP&#58;IO18(CLK)</td>
<td align="left">EPD&#58;SCK</td>
</tr>
<tr>
<td align="left">ESP&#58;IO19</td>
<td align="left">EPD&#58;CS_M</td>
</tr>
<tr>
<td align="left">ESP&#58;IO22</td>
<td align="left">EPD&#58;CS_S</td>
</tr>
<tr>
<td align="left">ESP&#58;IO21</td>
<td align="left">EPD&#58;DC</td>
</tr>
<tr>
<td align="left">ESP&#58;IO17</td>
<td align="left">EPD&#58;RST</td>
</tr>
<tr>
<td align="left">ESP&#58;IO16</td>
<td align="left">EPD&#58;BUSY</td>
</tr>
<tr>
<td align="left">ESP&#58;IO4</td>
<td align="left">EPD&#58;PWR</td>
</tr>
<tr>
<td align="left">ESP&#58;IO3(RXD)</td>
<td align="left">CON&#58;RXD</td>
</tr>
<tr>
<td align="left">ESP&#58;IO1(TXD)</td>
<td align="left">CON&#58;TXD</td>
</tr>
</table>
<p>ESPはアダプターボードに取り付けたESP32、EPDは電子ペーパー、BATは電池、CONはファームウェア書き込み用のコネクタです。電池は単3電池3本を使い、電子ペーパーには4.5Vを供給し、ESP32にはMCP1700T-3302Eで安定化した3.3Vを供給します。流れる電流が大きいので、接触抵抗の低い電池ボックスを使用しています。ケースは11x14インチの写真立てを使用しました。</p>
<div align="center">
<figure style="display: inline-table;"><a href="front.jpg"><figcaption>ケースに入れた状態(表)</figcaption></a></figure>
<figure style="display: inline-table;"><a href="back.jpg"><figcaption>ケースに入れた状態(裏)</figcaption></a></figure>
</div>
<h2>ソフトウェア</h2>
<p>この13.3インチをフォトフレームとして使うためにArduinoのESP32用のファームウェアを書きました。作成したファームウェアは<a href="https&#58;//github.com/middle-river/color_epd_photo3/tree/main/firmware">こちら</a>です。</p>
<h3>動作モード</h3>
<p>このフォトフレームは通常はディープスリープでマイコンを停止していますが、指定したスリープ時間が経過するかタクトスイッチ(GPIO0に接続)が押されるとスリープから復帰して画像表示を行います。また電源投入時にそのスイッチを押すことにより各種設定や画像データの転送を行うことができます。具体的には、下記の動作モードがあります。</p>
<ul>
<li><strong>設定モード</strong><br>電源を入れて3秒以内にスイッチを2秒以上押すとこのモードに入る。空文字列をkeyとして送信するとスリープする。</li>
<li><strong>同期モード</strong><br>電源を入れて3秒以内にスイッチを2秒未満押すとこのモードに入る。同期処理後にスリープする。</li>
<li><strong>転送モード</strong><br>電源を入れて3秒以内にスイッチを2回押すとこのモードに入る。スイッチを押すとスリープする。</li>
<li><strong>1つ次の画像を表示</strong><br>スイッチを2秒未満押してスリープ復帰するか、スリープ時間の経過によりスリープ復帰するとこのモードに入る。1つ次の画像を表示した後スリープする。</li>
<li><strong>1つ前の画像を表示</strong><br>スイッチを2秒以上押してスリープ復帰するとこのモードに入る。1つ前の画像を表示した後スリープする。</li>
<li><strong>5つ次の画像を表示</strong><br>スイッチを2回押してスリープ復帰するとこのモードに入る。5つ次の画像を表示した後スリープする。</li>
<li><strong>5つ前の画像を表示</strong><br>スイッチを3回押してスリープ復帰するとこのモードに入る。5つ前の画像を表示した後スリープする。</li>
</ul>
<p>設定モードでは、アクセスポイントモード(親機)でHTTPサーバーを動かします．スマホやタブレットで接続して(SSIDは&quot;ESP32&quot;、パスワードは&quot;12345678&quot;、接続先は&quot;http&#58;//192.168.0.1/&quot;)、転送モードや同期モードで使うアクセスポイントのSSID、そのパスワード、同期先、およびスリープ時間(単位は秒)を設定します。任意のキーと値のペアを登録できるので、それぞれ&quot;SSID&quot;、&quot;PASS&quot;、&quot;URL&quot;、&quot;SLEEP&quot;というキーに対する値として登録します．設定した値はフラッシュメモリ上に保存されます．</p>
<p>同期モードでは、指定したWebサーバーのディレクトリにある画像ファイルをESP32に転送して同期させます。設定モードで&quot;URL&quot;のキーに対して同期先を登録しておきます。Basic認証がある場合は&quot;http&#58;//user&#58;password@example.com/dir/subdir/&quot;のように指定できます。スラッシュで終わるディレクトリを指定します。なおファイルサイズを参照してファイルの一致性を調べるため、ファイルを更新してもファイルサイズが変わらないと同期できません。また、config.txtというファイルにキーと値をタブ区切りで入れておくと、設定モードと同様にキー値に対する値を登録できます。画像を置いておくディレクトリには、ファイル一覧を得られるようにするため以下の内容で.htaccessとindex.cgiファイルも置いておく必要があります。</p>

<pre style="background-color: #ccffcc">
[.htaccess]
Options +ExecCGI
AddHandler cgi-script .cgi

[index.cgi]
#!/bin/sh
echo "Content-Type: text/plain"
echo ""
find . -maxdepth 1 -name "*.gif" -printf '%s %f\n'
</pre>
<p>転送モードでは、ステーションモード(子機)でアクセスポイントに接続してFTPサーバーを動かします．適当なFTPクライアントソフトで接続して、画像ファイルのアップロードや削除を行います．WindowsであればファイルエクスプローラーをFTPクライアントとして使えます。ESP32のデータ領域のフラッシュメモリは、LittleFSをファイルシステムに使いファイルを管理しました．フォトフレームで表示させる画像ファイルは全てルートディレクトリに置きます．ArduinoのSimpleFTPServerというライブラリを使用しました(SPIFFSではなくLittleFSを使うため、FtpServerKey.hのDEFAULT_STORAGE_TYPE_ESP32をSTORAGE_SPIFFSからSTORAGE_LITTLEFSに変更します)。</p>
<h3>画像データと表示</h3>
<p>画像データは前回同様にGIFフォーマットで格納します。今回の電子ペーパーは表示領域の左右それぞれにコントローラーが割り当てられて別々に転送を行う必要があるため、事前に1200x1600の画像を左右に分割して縦につなげた600x3200の画像に変換しておきます。ファイルサイズは画像にもよりますが、250〜450KB程度でした。LittleFSに15MBを割り当てたとして画像サイズを250KBとすると、60枚程度保存することができます。</p>
<p>ESP32の電源電圧と現在何番目の画像を表示しているかを、画面左上に表示します。</p>
<h2>おわりに</h2>
<p>このSpectra 6のカラー電子ペーパーは、ACePのカラー電子ペーパーと比較して、期待していたほど画質に違いはありませんでした。横に並べて比較すれば違いは分かりますが、液晶ディスプレイとは異なり各ピクセルで6色しか表示できないためにディザリングを使う必要があるので、画像が荒くなるという問題は変わりません。ただし描画速度がやや速くなるのは利点だと思います。</p>
<hr>
<p><a href="https&#58;//github.com/middle-river">[Home]</a></p>
<div align="right">
2025-01 Project finished.<br>2025-01-26 Page created.<br>T. Nakagawa
</div>
</body>
</html>
